Lukaszm94/PomodoroElectronics/Pomodoro_v1.0/BOM/Pomodoro_v1.ods

Reference | Quantity | Value | Footprint | Link
BZ1 | 1 | Buzzer | BUZZERS_TDK:BUZZERS_TDK | https://pl.mouser.com/ProductDetail/TDK/PS1240P02BT?qs=sGAEpiMZZMsK322k1rNFfYfXmCWsjkB8iQfg2vl062k%3d
C1 | 1 | 4u7 | Capacitors_SMD:C_0805 | https://www.tme.eu/pl/details/cl21a475kpfnnng/kondensatory-mlcc-smd-0805/samsung/
C10 C8 | 2 | 1u | Capacitors_SMD:C_0805
C2 | 1 | 22p | Capacitors_SMD:C_0805
C11 C13 C14 C3 | 4 | 10u | Capacitors_SMD:C_0805
C12 C4 C5 C6 C7 C9 | 6 | 100n | Capacitors_SMD:C_0805 | https://pl.mouser.com/ProductDetail/810-C2012JB2A104K12A
D1 D2 | 2 | R | LEDs:LED_0805 | https://www.tme.eu/pl/details/osr50805c1e/diody-led-smd-kolorowe/optosupply/
D11 | 1 | LED_BGR | LEDs:LED_RGB_5050-6 | https://www.tme.eu/pl/details/fyls-5050nrgbc/diody-led-smd-kolorowe/foryard/
D3 D4 D5 D6 | 4 | Y | LEDs:LED_0805 | https://www.tme.eu/pl/details/osy50805c1e/diody-led-smd-kolorowe/optosupply/
D10 D7 D8 D9 | 4 | G | LEDs:LED_0805 | https://www.tme.eu/pl/details/ll-s170pgc-g5-1a/diody-led-smd-kolorowe/lucky-light/
J1 | 1 | BATT | Connectors_JST:s3b-ph-kl | https://www.tme.eu/pl/details/s3b-ph-k-s/zlacza-sygnalowe-raster-200mm/jst/
J13 | 1 | SWIM | Connectors_JST:JST_PH_B4B-PH-K_04x2.00mm_Straight
J3 | 1 | USB_OTG | Connectors_USB:USB_Micro-B_Molex-105017-0001 | https://www.tme.eu/pl/details/mx-105017-0001/zlacza-usb-i-ieee1394/molex/1050170001/
J5 | 1 | UART | Pin_Headers:Pin_Header_Straight_1x03_Pitch2.54mm
L1 | 1 | 2u2 | LPS3015:LPS3015 | https://pl.mouser.com/ProductDetail/Coilcraft/LPS3015-222MRC?qs=QQJxVsr8EGa5yK41CDha%252bg==
L2 | 1 | BEAD | Inductors_SMD:L_0805 | https://pl.mouser.com/ProductDetail/Bourns/MG2029-101Y
Q1 Q2 | 2 | BC807 | TO_SOT_Packages_SMD:SOT-23 | https://pl.mouser.com/ProductDetail/Nexperia/BC807215?qs=sGAEpiMZZMvKM5ialpXrmhmqXJPocDa9
R10 R22 R5 | 3 | 100K | Resistors_SMD:R_0805 | https://pl.mouser.com/ProductDetail/Panasonic-Industrial-Devices/ERJ-6ENF1003V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
R11 R12 R13 R14 | 4 | 10R | Resistors_SMD:R_0805 | https://www.tme.eu/pl/details/smd0805-10r/rezystory-smd-0805/royal-ohm/0805s8j0100t5e/
R15 R16 R31 R33 | 4 | 0R | Resistors_SMD:R_0805
R1 R17 R2 R3 R4 R6 R9 | 7 | 200R | Resistors_SMD:R_0805 | https://pl.mouser.com/ProductDetail/ROHM-Semiconductor/ESR10EZPJ201
R18 | 1 | 66k5 | Resistors_SMD:R_0805 | https://www.tme.eu/pl/details/crcw080566k5fktabc/rezystory-smd-0805/vishay/
R19 | 1 | 2K49 | Resistors_SMD:R_0805 | https://www.tme.eu/pl/details/smd0805-2k49-1%25/rezystory-smd-0805/royal-ohm/0805s8f2491t5e/
R20 | 1 | 1k6 | Resistors_SMD:R_0805 | https://www.tme.eu/pl/details/crcw08051k60fktabc/rezystory-smd-0805/vishay/
R21 | 1 | 390K | Resistors_SMD:R_0805 | https://www.tme.eu/pl/details/smd0805-390k-1%25/rezystory-smd-0805/royal-ohm/0805s8f3903t5e/
R23 | 1 | R | Resistors_SMD:R_0805
R24 R25 | 2 | 470K | Resistors_SMD:R_0805 | https://pl.mouser.com/ProductDetail/Panasonic-Industrial-Devices/ERJ-6ENF4703V
R27 | 1 | 16K2 | Resistors_SMD:R_0805 | https://pl.mouser.com/ProductDetail/Panasonic-Industrial-Devices/ERJ-6ENF1622V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
R28 | 1 | 1M(DNP) | Resistors_SMD:R_0805
R29 | 1 | 1K | Resistors_SMD:R_0805
R30 | 1 | 4K7 | Resistors_SMD:R_0805
R32 | 1 | R_PHOTO | Pin_Headers:Pin_Header_Straight_1x02_Pitch2.54mm | https://www.tme.eu/pl/details/pgm5539/fotorezystory/token/
R26 R34 R7 | 3 | 10K | Resistors_SMD:R_0805
R8 | 1 | 1M | Resistors_SMD:R_0805
SW1 | 1 | SLIDER | SLIDE_SWITCHES:5MS1S102AM6QE | https://www.tme.eu/pl/details/5ms1s102am6qe/przelaczniki-suwakowe/
SW2 | 1 | BUTTON_SPST | NINIGI_TACTS-24N-F:NINIGI_TACTS-24N-F | https://www.tme.eu/pl/details/tacts-24n-f/mikroprzelaczniki-tact/ninigi/
U2 | 1 | TPS62260 | TO_SOT_Packages_SMD:SOT-23-5 | https://pl.mouser.com/ProductDetail/Texas-Instruments/TPS62260DDCT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
U3 | 1 | STM8L151C2T6 | Housings_QFP:LQFP-48_7x7mm_Pitch0.5mm | https://pl.mouser.com/ProductDetail/STMicroelectronics/STM8L151C2T6
U1 | 1 | MCP73833T-FCI/MF |  | https://pl.mouser.com/ProductDetail/579-MCP73833T-FCI-MF
U4 | 1 | AS1122-BQFT |  | https://pl.mouser.com/ProductDetail/985-AS1122-BQFT
