Lukaszm94/PomodoroElectronics/Pomodoro_v1.0/PDF/Pomodoro_v1.pdf

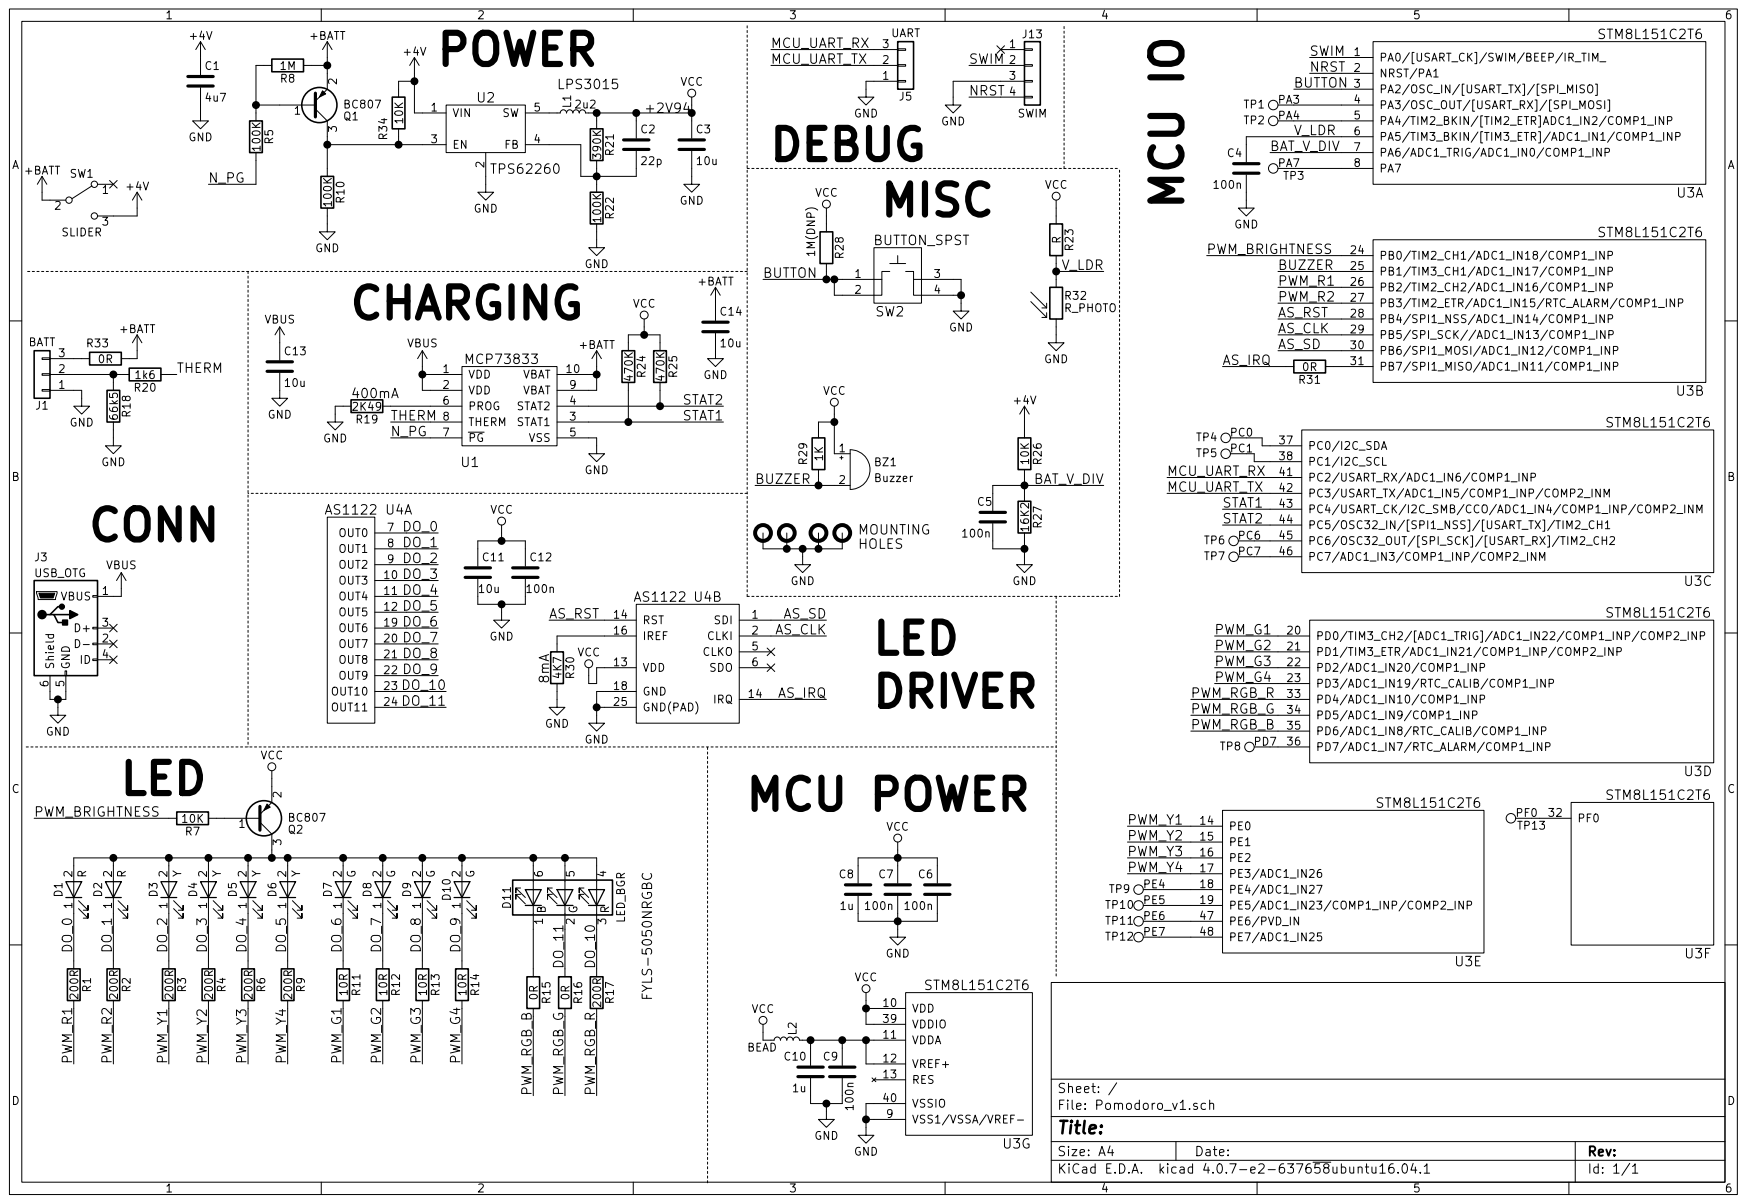
[picture p1: page 1]
