Lukaszm94/PomodoroElectronics/Pomodoro_v1.0/Simulations/power_switching.asc

Q1: npn; BC847A
Q2: pnp; BC807-25
R1: res; 100K
R2: res; 100K
R3: res; 1K
R4: res; 1000K
R5: res; 0.001R
V1: voltage; 3
V2: voltage; 3.8
Named nets: 0, EN
.tran 1
Inside MCP73833
R5 simulates slider in ON position
