Lukaszm94/PomodoroElectronics/Pomodoro_v1.0/Pomodoro_v1.kicad_pcb

## KiCad design Pomodoro_v1.0/Pomodoro_v1.kicad_pcb (2018-09-03)

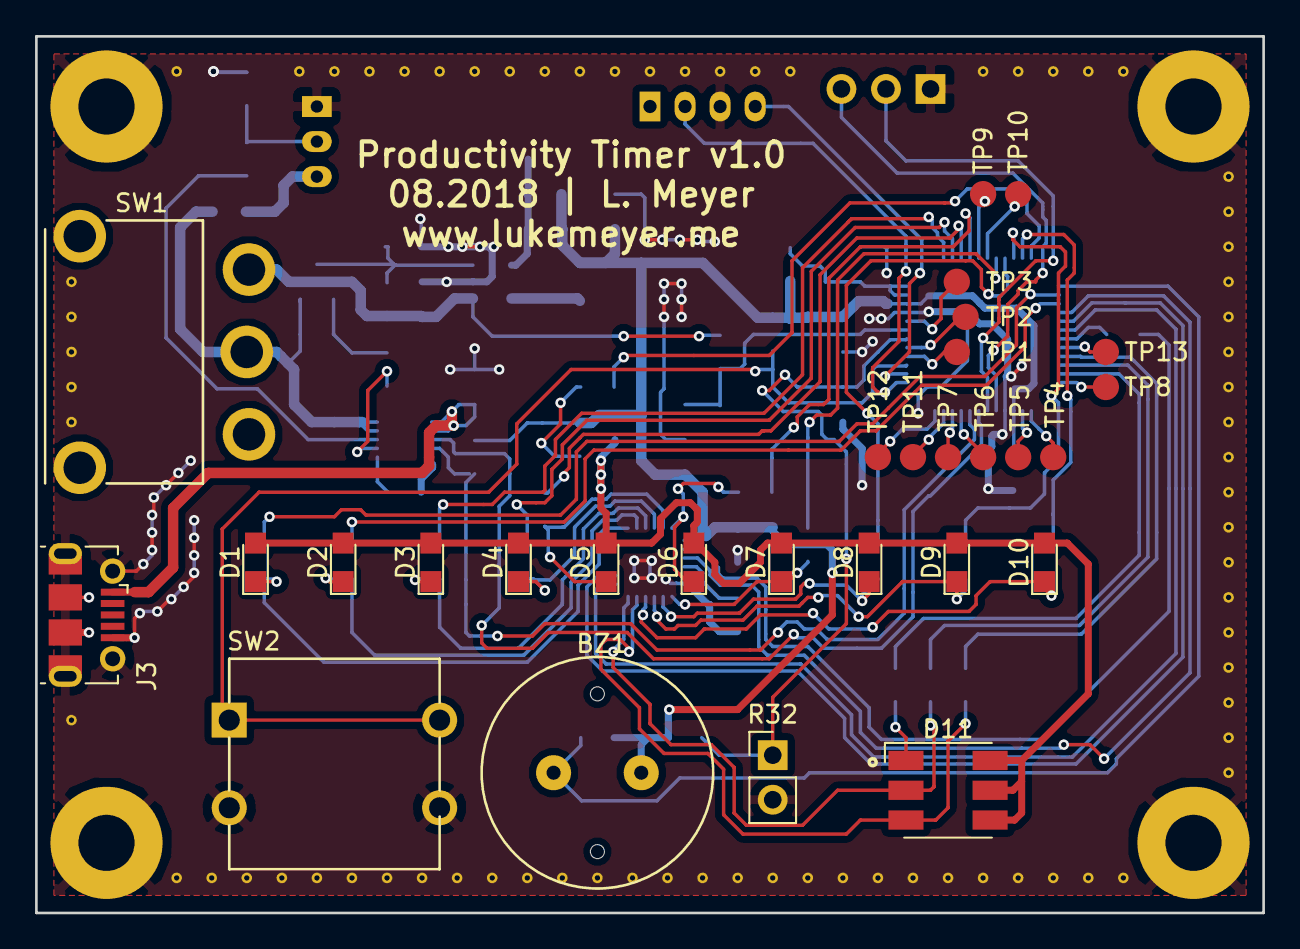
[picture p2: board Pomodoro_v1.kicad_pcb from above]

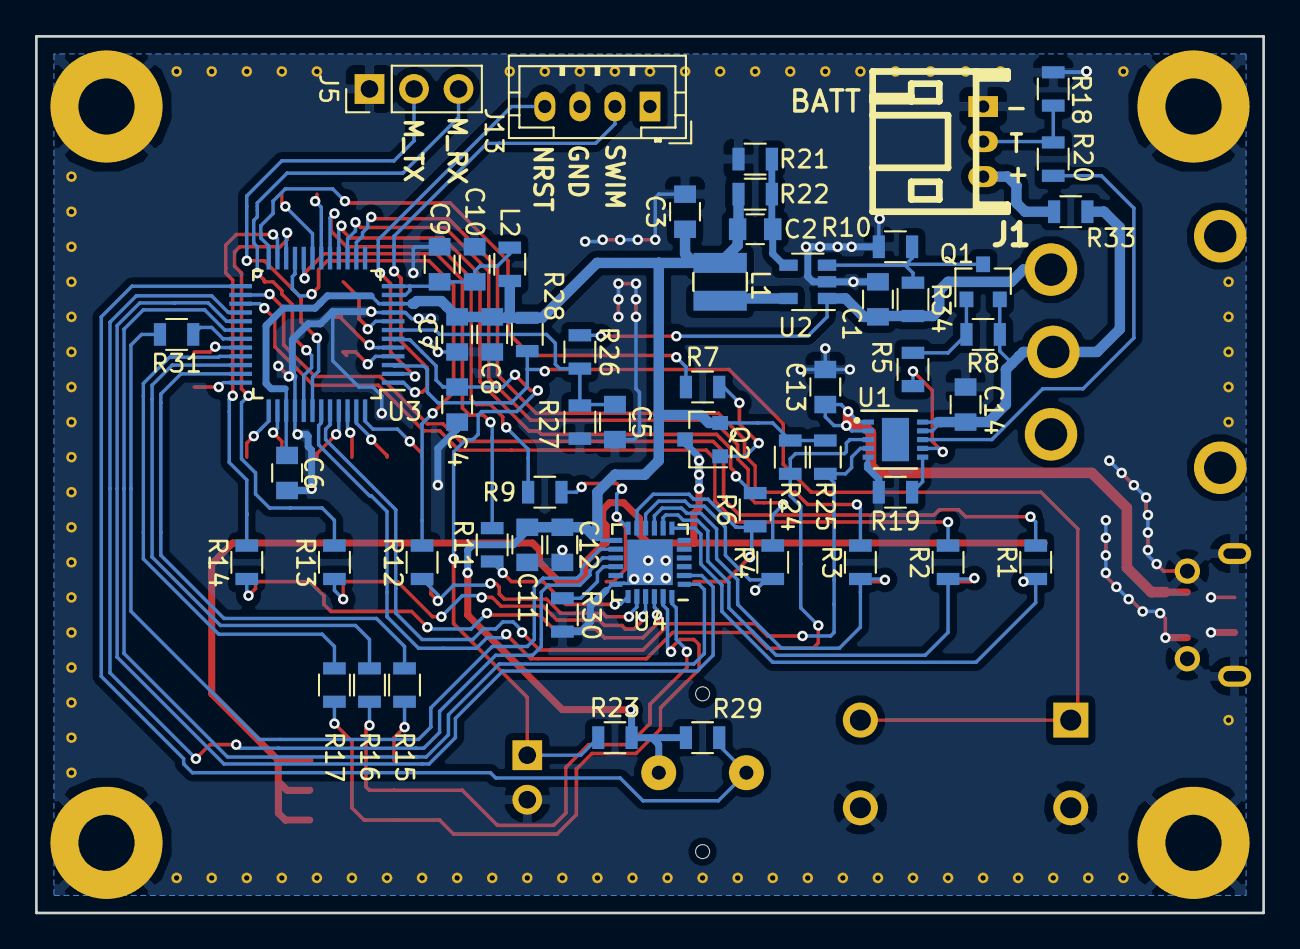
[picture p3: board Pomodoro_v1.kicad_pcb from below]

Board: 2 copper layers, 70.0 x 50.0 mm, 91 parts (58 on the bottom side), 72 nets.

Parts:
BZ1: Buzzer; BUZZERS_TDK
C1: 4u7; C_0805
C2: 22p; C_0805
C3, C11, C13, C14: 10u; C_0805
C4, C5, C6, C7, C9, C12: 100n; C_0805
C8, C10: 1u; C_0805
D1, D2: R; LED_0805
D3, D4, D5, D6: Y; LED_0805
D7, D8, D9, D10: G; LED_0805
D11: LED_BGR; LED_RGB_5050-6
J1: BATT; s3b-ph-kl
J3: USB_OTG; USB_Micro-B_Molex-105017-0001
J5: UART; Pin_Header_Straight_1x03_Pitch2.54mm
J13: SWIM; JST_PH_B4B-PH-K_04x2.00mm_Straight
L1: 2u2; LPS3015
L2: BEAD; L_0805
M1, M2, M3, M4: MOUNTING-HOLE; MountingHole_3.2mm_M3_Pad
Q1, Q2: BC807; SOT-23
R1, R2, R3, R4, R6, R9, R17: 200R; R_0805
R5, R10, R22: 100K; R_0805
R7, R26, R34: 10K; R_0805
R8: 1M; R_0805
R11, R12, R13, R14: 10R; R_0805
R15, R16, R31, R33: 0R; R_0805
R18: 66k5; R_0805
R19: 2K49; R_0805
R20: 1k6; R_0805
R21: 390K; R_0805
R23: R; R_0805
R24, R25: 470K; R_0805
R27: 16K2; R_0805
R28: 1M(DNP); R_0805
R29: 1K; R_0805
R30: 4K7; R_0805
R32: R_PHOTO; Pin_Header_Straight_1x02_Pitch2.54mm
SW1: SLIDER; 5MS1S102AM6QE
SW2: BUTTON_SPST; NINIGI_TACTS-24N-F
TP1: PA3; Measurement_Point_Round-SMD-Pad_Small
TP2: PA4; Measurement_Point_Round-SMD-Pad_Small
TP3: PA7; Measurement_Point_Round-SMD-Pad_Small
TP4: PC0; Measurement_Point_Round-SMD-Pad_Small
TP5: PC1; Measurement_Point_Round-SMD-Pad_Small
TP6: PC6; Measurement_Point_Round-SMD-Pad_Small
TP7: PC7; Measurement_Point_Round-SMD-Pad_Small
TP8: PD7; Measurement_Point_Round-SMD-Pad_Small
TP9: PE4; Measurement_Point_Round-SMD-Pad_Small
TP10: PE5; Measurement_Point_Round-SMD-Pad_Small
TP11: PE6; Measurement_Point_Round-SMD-Pad_Small
TP12: PE7; Measurement_Point_Round-SMD-Pad_Small
TP13: PF0; Measurement_Point_Round-SMD-Pad_Small
U1: MCP73833; DFN-10-1EP_3x3mm_Pitch0.5mm
U2: TPS62260; SOT-23-5
U3: STM8L151C2T6; LQFP-48_7x7mm_Pitch0.5mm
U4: AS1122; QFN-24_4x4mm_Pitch0.5mm_NoMask

Connections:
+4V: C1.1, R26.1, R34.1, SW1.3, U2.1
+BATT: C14.1, Q1.2, R8.1, R33.1, SW1.2, U1.9, U1.10
/AS_CLK: U3.29, U4.2
/AS_IRQ: R31.2, U4.14
/AS_SD: U3.30, U4.1
/BAT_V_DIV: C5.1, R26.2, R27.1, U3.7
/BUTTON: R28.2, SW2.1, SW2.2, U3.3
/BUZZER: BZ1.2, R29.2, U3.25
/DO_0: D1.1, R1.1, U4.7
/DO_1: D2.1, R2.1, U4.8
/DO_2: D3.1, R3.1, U4.9
/DO_3: D4.1, R4.1, U4.10
/DO_4: D5.1, R6.1, U4.11
/DO_5: D6.1, R9.1, U4.12
/DO_6: D7.1, R11.1, U4.19
/DO_7: D8.1, R12.1, U4.20
/DO_8: D9.1, R13.1, U4.21
/DO_9: D10.1, R14.1, U4.22
/DO_10: D11.3, R17.1, U4.23
/DO_11: D11.2, R16.1, U4.24
/MCU_UART_RX: J5.3, U3.41
/MCU_UART_TX: J5.2, U3.42
/NRST: J13.4, U3.2
/N_PG: R5.2, U1.7
/PWM_BRIGHTNESS: R7.2, U3.24
/PWM_G1: R11.2, U3.20
/PWM_G2: R12.2, U3.21
/PWM_G3: R13.2, U3.22
/PWM_G4: R14.2, U3.23
/PWM_R1: R1.2, U3.26
/PWM_R2: R2.2, U3.27
/PWM_RGB_B: R15.2, U3.35
/PWM_RGB_G: R16.2, U3.34
/PWM_RGB_R: R17.2, U3.33
/PWM_Y1: R3.2, U3.14
/PWM_Y2: R4.2, U3.15
/PWM_Y3: R6.2, U3.16
/PWM_Y4: R9.2, U3.17
/STAT1: R24.2, U1.3, U3.43
/STAT2: R25.2, U1.4, U3.44
/SWIM: J13.2, U3.1
/THERM: R20.1, U1.8
/V_LDR: C4.1, R23.2, R32.1, U3.6
GND: C1.2, C3.2, C4.2, C5.2, C6.2, C7.2, C8.2, C9.2, C10.2, C11.2, C12.2, C13.2, C14.2, J1.1, J3.5, J3.6, J5.1, J13.3, M1.1, M2.1, M3.1, M4.1, R10.2, R18.2, R19.2, R22.2, R27.2, R30.2, R32.2, SW2.3, SW2.4, U1.5, U2.2, U3.9, U3.40, U4.18, U4.25
unnamed: C2.2, R21.2, R22.1, U2.4
unnamed: C9.1, C10.1, L2.1, U3.11, U3.12
unnamed: D1.2, D2.2, D3.2, D4.2, D5.2, D6.2, D7.2, D8.2, D9.2, D10.2, D11.4, D11.5, D11.6, Q2.3
unnamed: D11.1, R15.1
unnamed: J1.2, R18.1, R20.2
unnamed: J1.3, R33.2
unnamed: L1.1, U2.5
unnamed: Q1.1, R5.1, R8.2
unnamed: Q1.3, R10.1, R34.2, U2.3
unnamed: Q2.1, R7.1
unnamed: R19.1, U1.6
unnamed: R30.1, U4.16
unnamed: R31.1, U3.31
unnamed: TP1.1, U3.4
unnamed: TP2.1, U3.5
unnamed: TP3.1, U3.8
unnamed: TP4.1, U3.37
unnamed: TP5.1, U3.38
unnamed: TP6.1, U3.45
unnamed: TP7.1, U3.46
unnamed: TP8.1, U3.36
unnamed: TP9.1, U3.18
unnamed: TP10.1, U3.19
unnamed: TP11.1, U3.47
unnamed: TP12.1, U3.48
unnamed: TP13.1, U3.32
VBUS: C13.1, J3.1, U1.1, U1.2
VCC: BZ1.1, C2.1, C3.1, C6.1, C7.1, C8.1, C11.1, C12.1, L1.2, L2.2, Q2.2, R21.1, R23.1, R24.1, R25.1, R28.1, R29.1, U3.10, U3.39, U4.13
