Lukaszm94/PomodoroElectronics/(commit log)

2018-06-23 Initial electronics commit
    [Pomodoro_v1.kicad_pcb, Pomodoro_v1.sch]
2018-06-29 add AS1122 to the schematic, started assigning footprints
    [Pomodoro_v1.sch]
2018-07-29 latop update
    [Pomodoro_v1.csv, Pomodoro_v1.ods, Pomodoro_v1.sch]
2018-08-01 assign footprints
    [Pomodoro_v1.kicad_pcb, Pomodoro_v1.sch]
2018-08-01 add components: slide switch, buzzer, USB connecotr, tact switch model and son on
2018-08-01 update footprints with 3D models
    [Pomodoro_v1-2018-08-01-20-25-01.sch, Pomodoro_v1.FCStd, Pomodoro_v1.kicad_pcb]
2018-08-18 remove backup PCB file
2018-08-18 Add JST connectors library, add STEP files
2018-08-18 Components placement done, initial routing (power tracks)
    [Pomodoro_v1.FCStd, Pomodoro_v1.kicad_pcb, Pomodoro_v1.sch]
2018-08-18 fix STAT_x/STATx typo
    [Pomodoro_v1.sch]
2018-08-18 routing in progress (mainly CPU section)
    [Pomodoro_v1.kicad_pcb]
2018-08-18 fix D0_x -> DO_x typo
    [Pomodoro_v1.sch]
2018-08-18 all signals are routed, need to fix a few GND connections
    [Pomodoro_v1.kicad_pcb]
2018-08-20 finish GND fixes, board is ready for manufacturing
    [Pomodoro_v1.kicad_pcb]
2018-08-28 Add via stitching + silkscreen placement
    [Pomodoro_v1.kicad_pcb]
2018-08-28 Generate gerber files
    [Pomodoro_v1-B.Cu.gbl, Pomodoro_v1-B.Mask.gbs, Pomodoro_v1-B.SilkS.gbo, Pomodoro_v1-Edge.Cuts.gm1, Pomodoro_v1-F.Cu.gtl, Pomodoro_v1-F.Mask.gts, Pomodoro_v1-F.SilkS.gto, Pomodoro_v1.drl]
2018-08-28 Minor silkscreen fixes + regenerate gerbers. Board is ready for manufacturing
    [Pomodoro_v1.kicad_pcb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]
2018-08-29 add compressed gerber files
2018-08-29 updated BOM
    [Pomodoro_v1.ods]
2018-08-29 remove old files
    [Pomodoro_v1.FCStd, Pomodoro_v1.csv]
2018-08-29 add missing compononets to BOM
    [Pomodoro_v1.ods]
2018-08-29 update BOM with links
    [Pomodoro_v1.ods]
2018-09-03 change JST PH connector 3D model
    [Pomodoro_v1.kicad_pcb]
2018-10-27 add exported PDF schematic
